karl-hong/magazineLock/doc/bullet_lock_v1.pdf

# 弹仓锁

## 4PIN

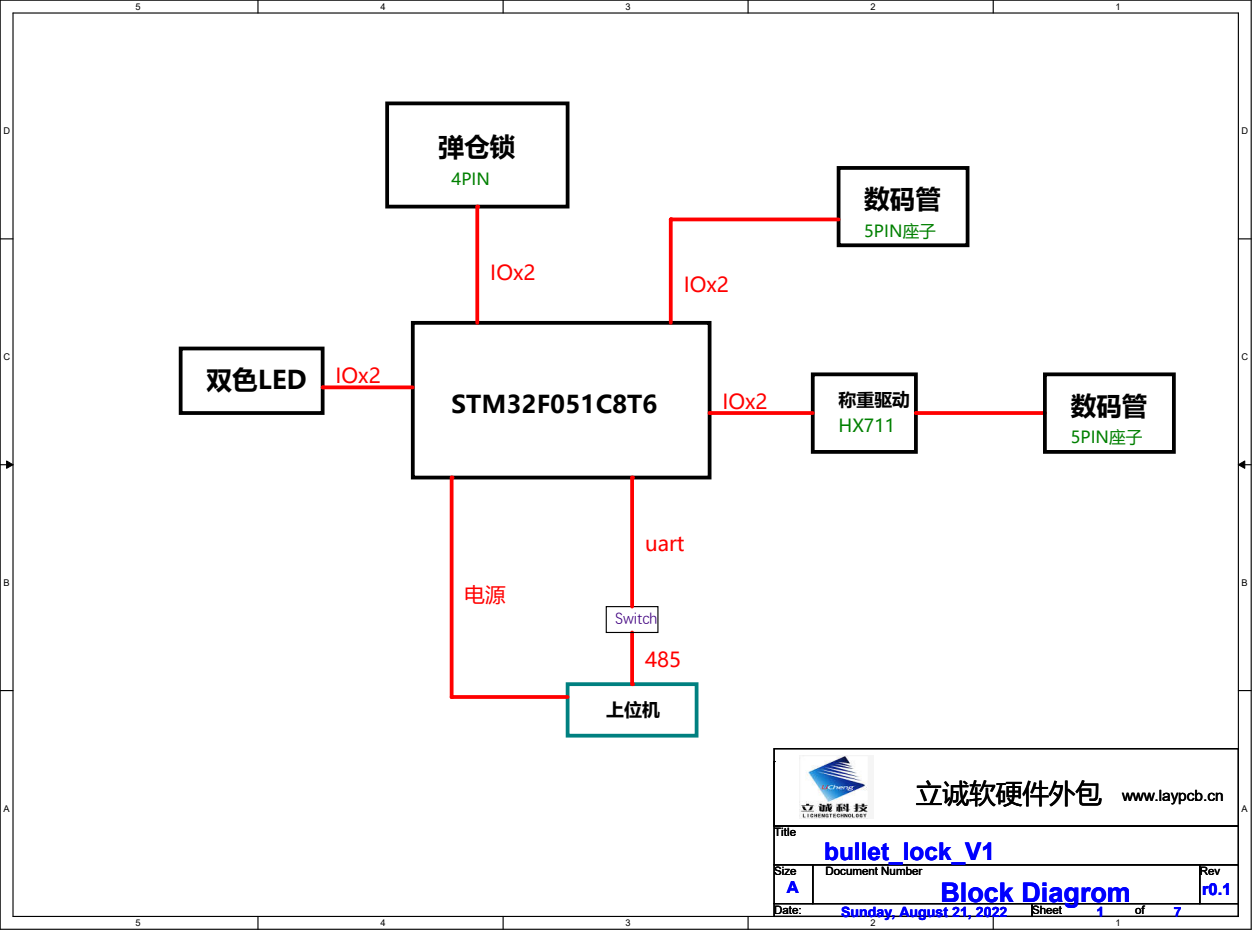
[picture p4: page 1]
STM32F051C8T6; 称重驱动; IOx2; 双色LED IOx2; 上位机; uart; Switch; 数码管; 5PIN座子; Title; Size; Document Number; Rev; Date:; Sheet; Block Diagrom; bullet_lock_V1; Sunday, August 21, 2022

立诚软硬件外包 www.laypcb.cn

# Revision

V1 | 2022.8.18 | 创建第一个版本

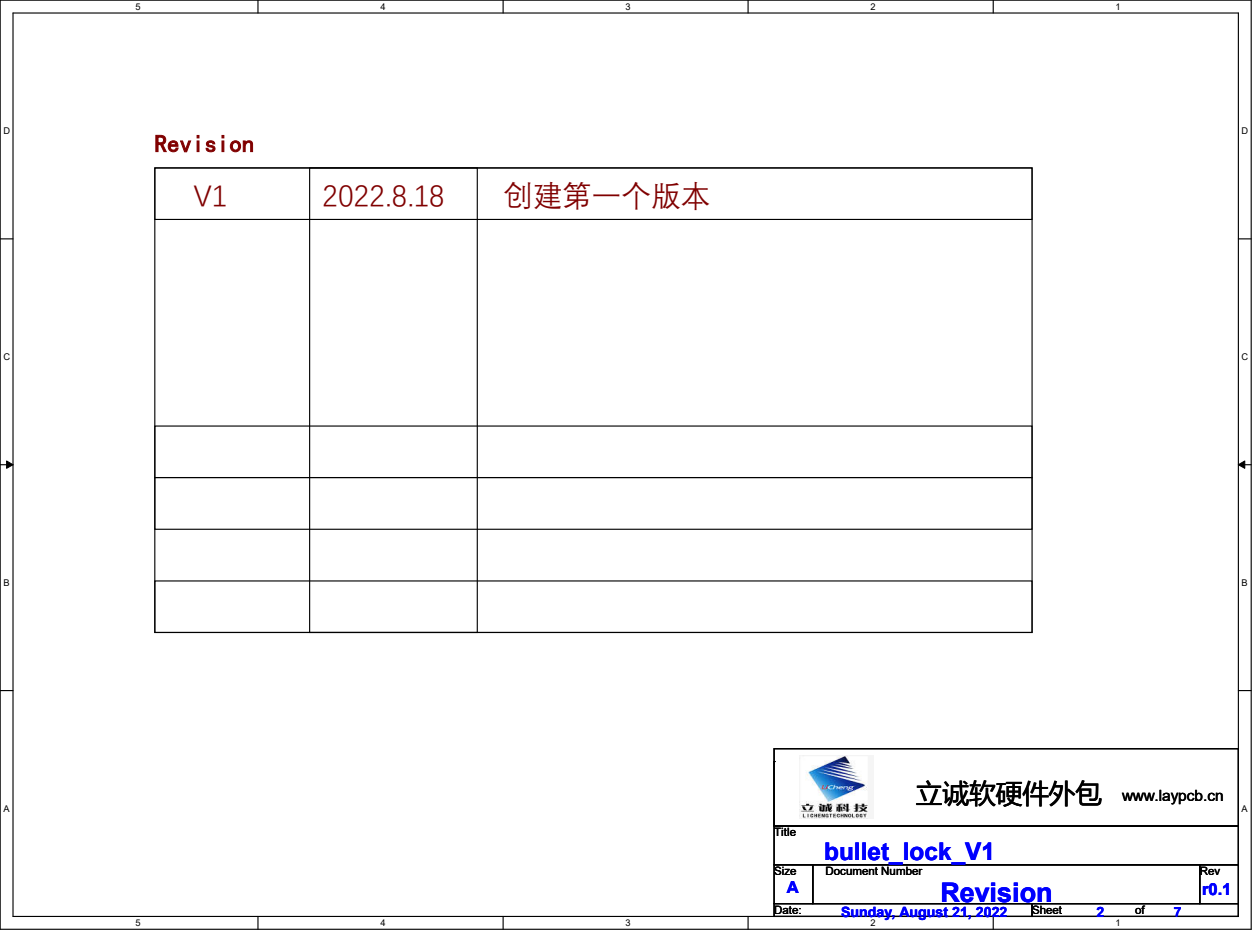
[picture p5: page 2]
Title; Revision; bullet_lock_V1; Sunday, August 21, 2022

立诚软硬件外包 www.laypcb.cn

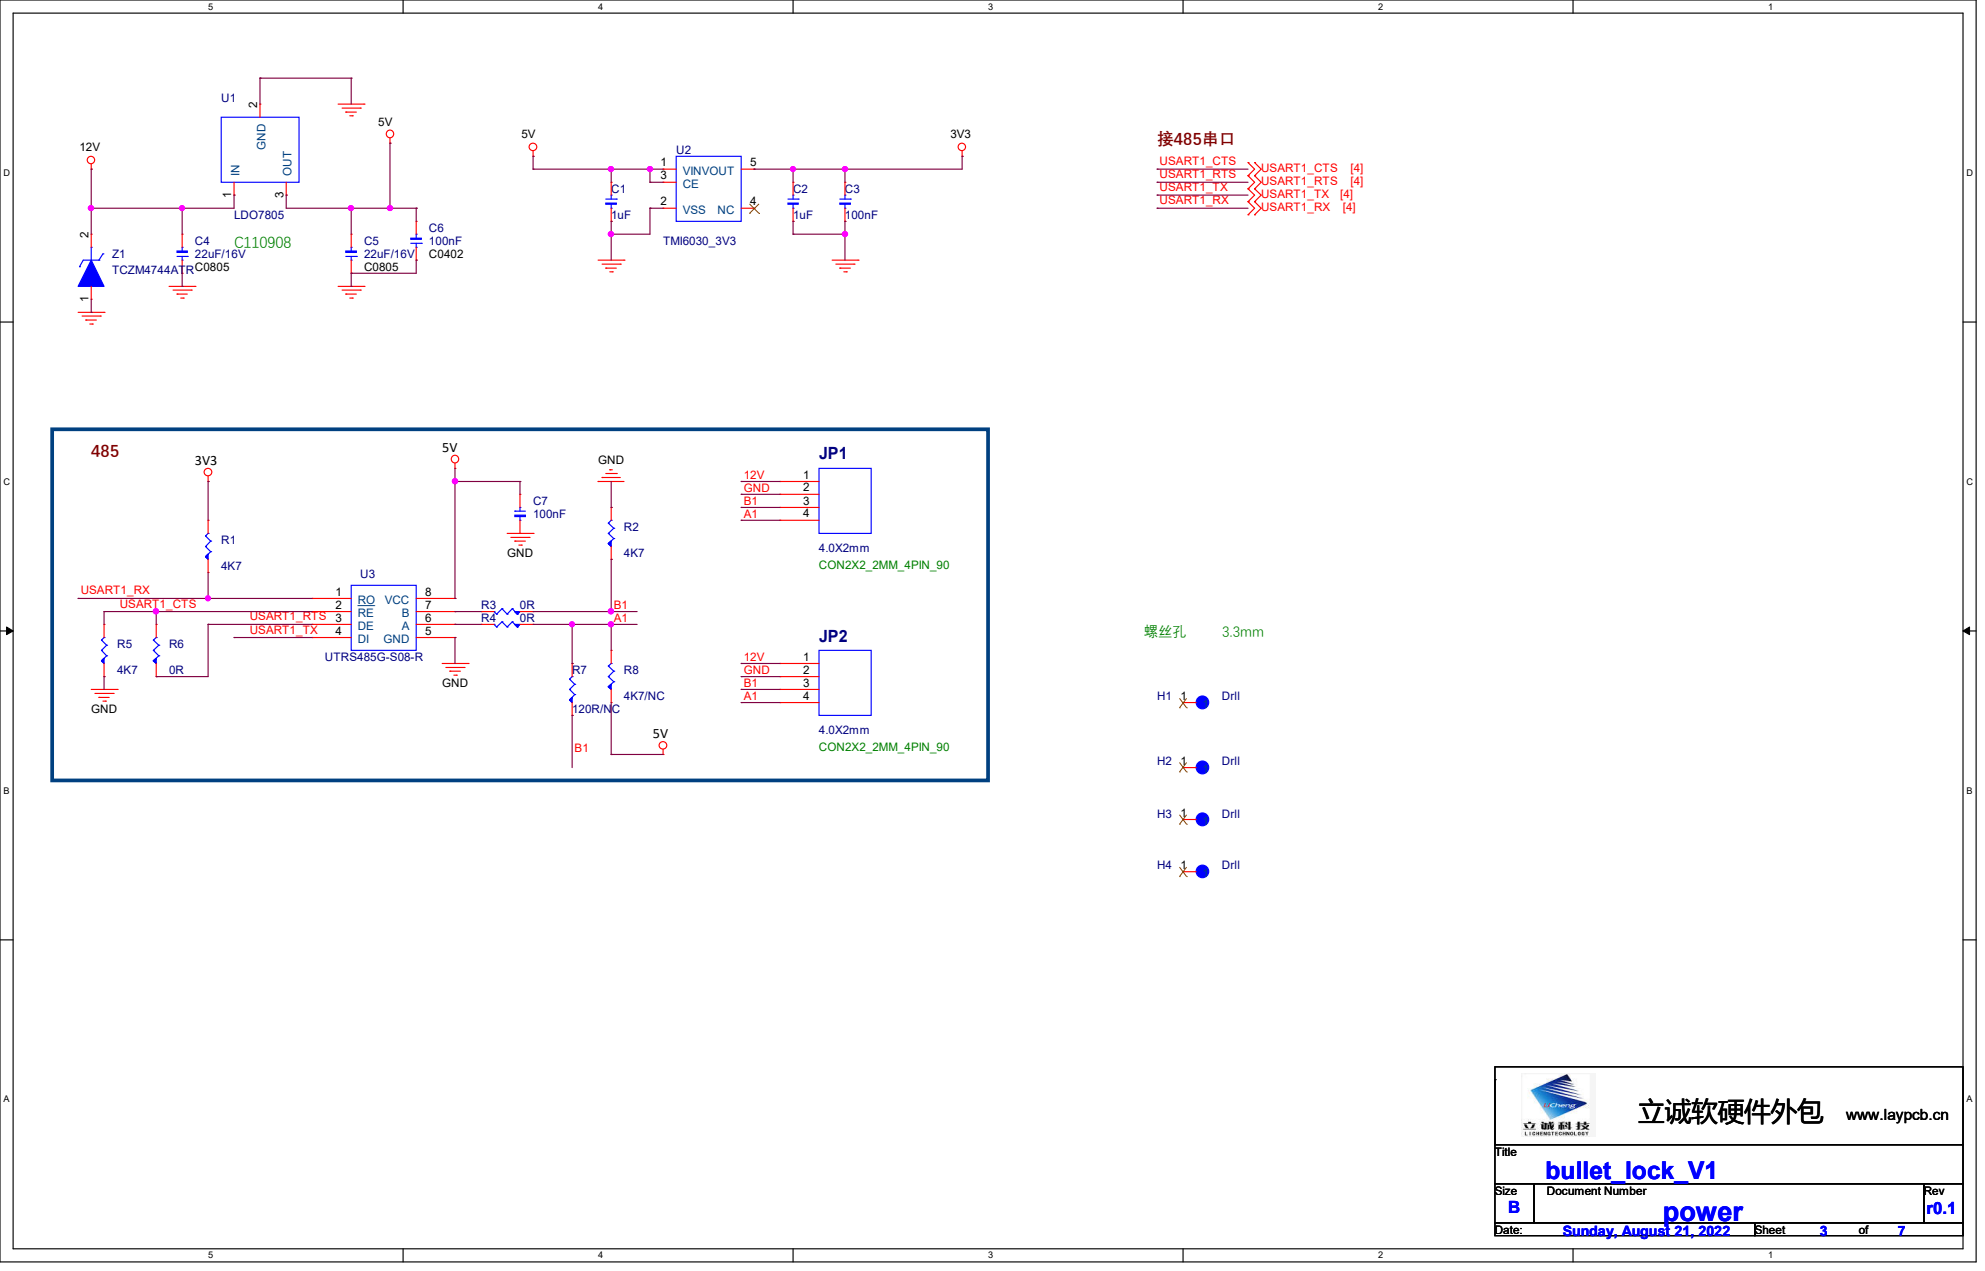
[picture p6: page 3]

立诚软硬件外包 www.laypcb.cn

## 接485串口

## 开锁和锁状态检测

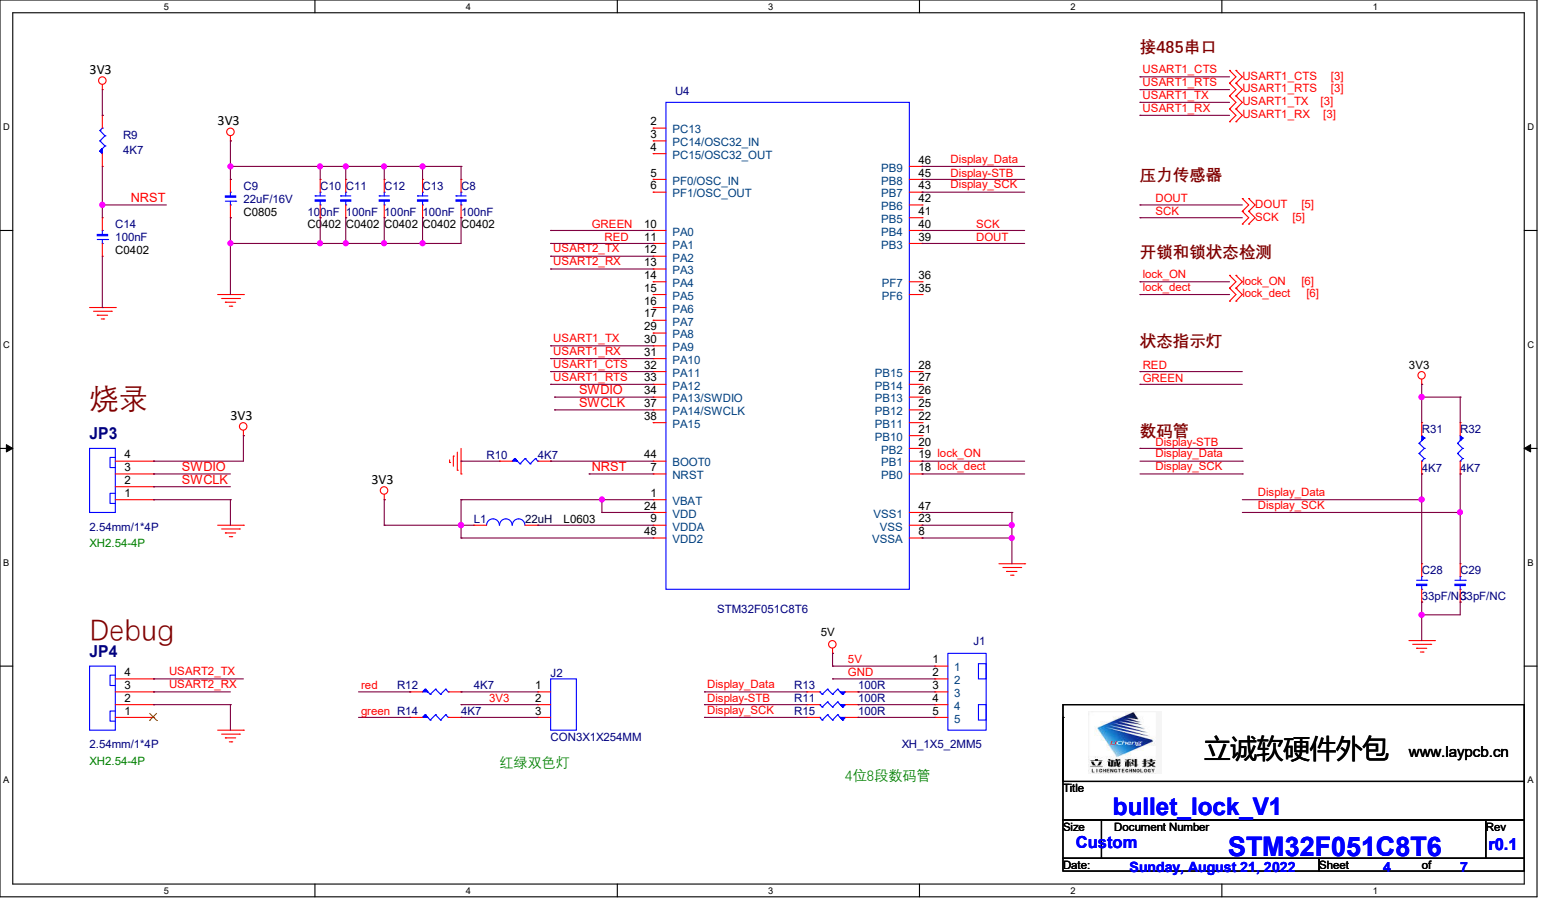
[picture p7: page 4]

立诚软硬件外包 www.laypcb.cn

## 压力传感器

5V

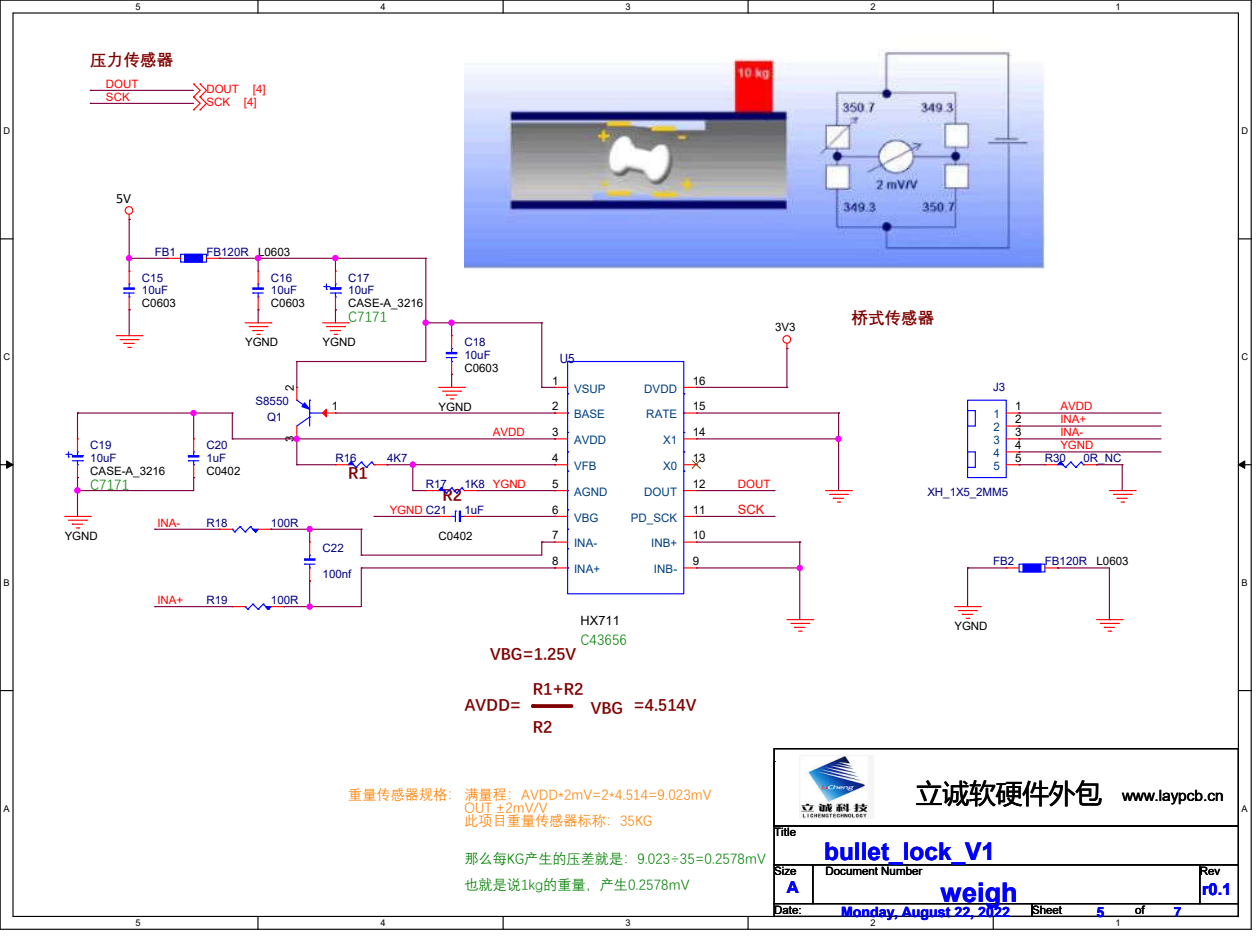
[picture p8: page 5]

立诚软硬件外包 www.laypcb.cn

## 上锁断开，开锁导通

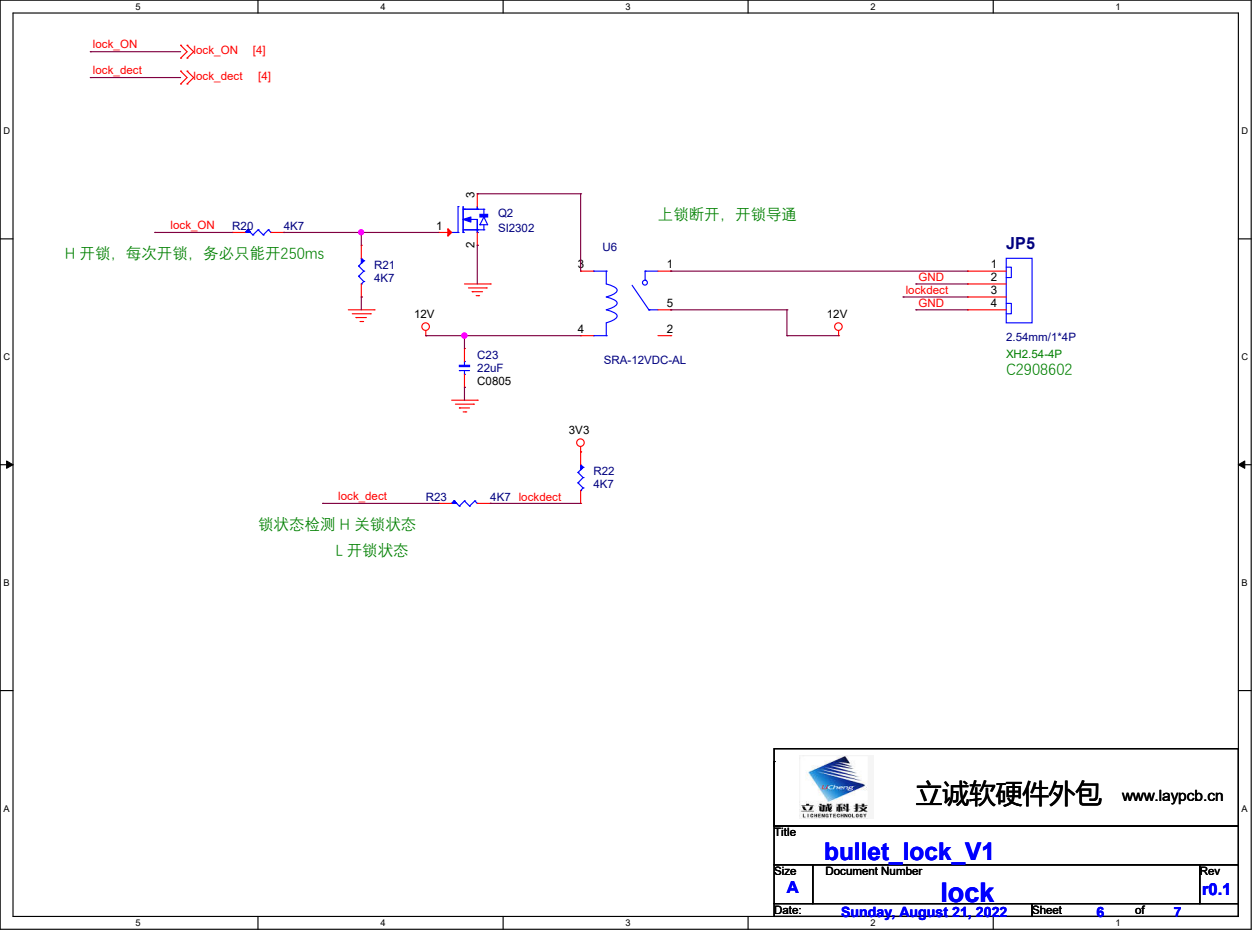
[picture p9: page 6]

立诚软硬件外包 www.laypcb.cn

## 4位8段数码管

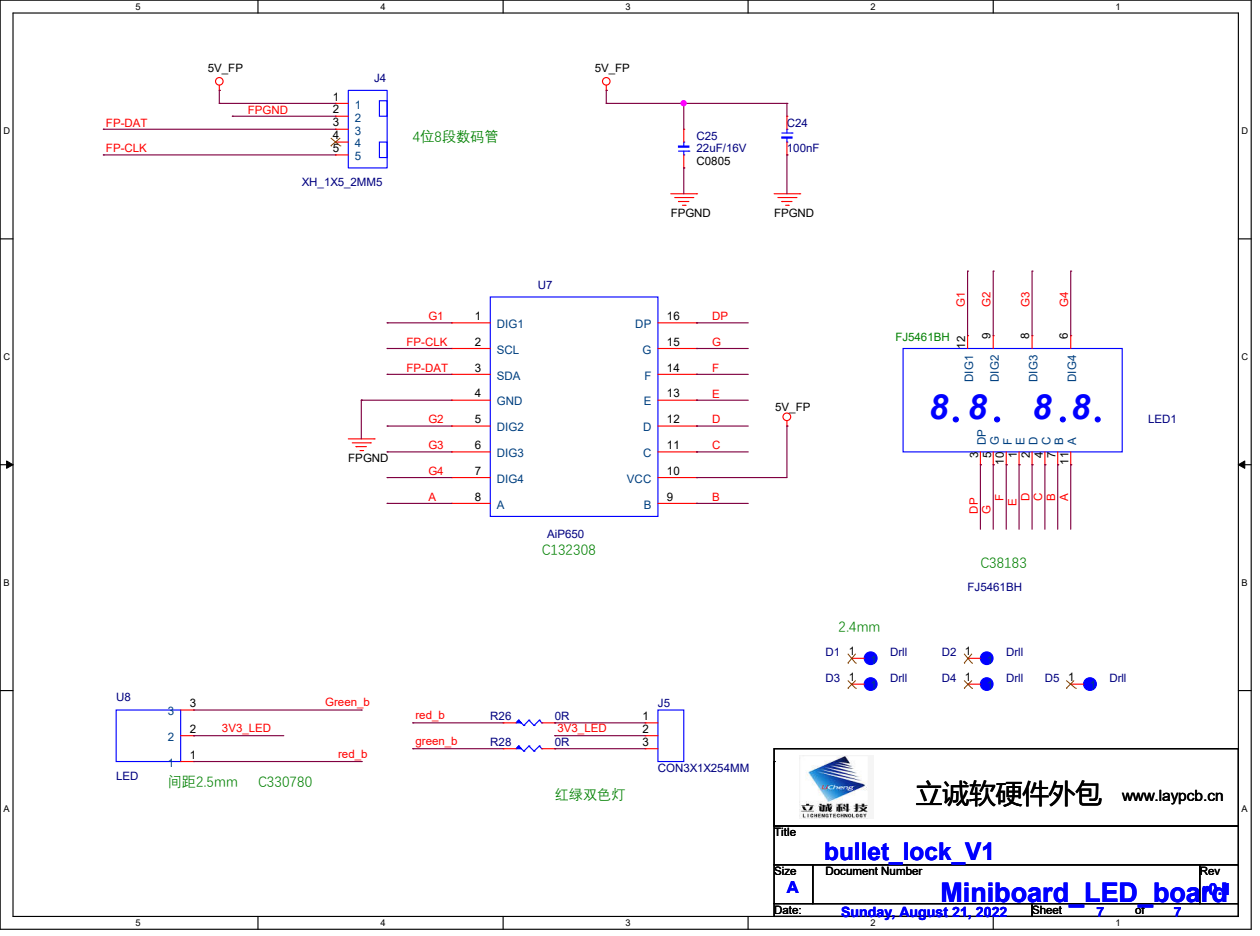
[picture p10: page 7]

立诚软硬件外包 www.laypcb.cn
