karl-hong/magazineLock/magazineLock/Core/Src/main.c

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
/* Includes ------------------------------------------------------------------*/
#include "main.h"
#include "iwdg.h"
#include "tim.h"
#include "usart.h"
#include "gpio.h"

/* USER CODE BEGIN Includes */
#include <stdio.h>
#include "user_protocol.h"
#include "common.h"
#include "user_data.h"
#include "AiP650.h"
#include "led.h"
#include "HX711.h"
#include "lock.h"
/* USER CODE END Includes */


/* USER CODE BEGIN PV */
lock_ctrl_t lock;
uint16_t logInterval = 0;
uint64_t u64ActWeight;
/* USER CODE END PV */

void SystemClock_Config(void);
/**
  * @brief  The application entry point.
  * @retval int
  */
int main(void)
{
  /* MCU Configuration--------------------------------------------------------*/

  /* Reset of all peripherals, Initializes the Flash interface and the Systick. */
  HAL_Init();

  /* USER CODE BEGIN Init */
	user_database_init();
  /* USER CODE END Init */

  /* Configure the system clock */
  SystemClock_Config();

  /* Initialize all configured peripherals */
  MX_GPIO_Init();
  MX_TIM14_Init();
  MX_USART1_UART_Init();
  MX_USART2_UART_Init();
  MX_IWDG_Init();
  /* USER CODE BEGIN 2 */
	AIP650Init();
	printSetting();
  lock_state_detect();
  /* USER CODE END 2 */

  /* Infinite loop */
  /* USER CODE BEGIN WHILE */
  while (1)
  {
    /* USER CODE END WHILE */

    /* USER CODE BEGIN 3 */
    MX_IWDG_Refresh();
		AIP650Task();
		Led_Task();
		HX711_task();
    Lock_Task();
    user_protocol_handle();
    user_reply_handle();
		user_huart_error_check();
		if(logInterval == 0){
			logInterval = 30;
      static uint32_t init_weight = 0;
      static uint32_t actual_weight = 0;
      if(init_weight == 0 && lock.magazineWeight){
        init_weight = lock.magazineWeight;
      }
      if(lock.magazineWeight >= init_weight){
        actual_weight = lock.magazineWeight - init_weight;
        actual_weight = actual_weight * 30 / 4456;//000;//206000;//2147483;
      }
			//printf("hx711 weight: %d kg\r\n", actual_weight);
			printf("hx711 weight: %d g\r\n", actual_weight);
		}
  }
  /* USER CODE END 3 */
}

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
