karl-hong/magazineLock/magazineLock/magazineLock.ioc

Mcu.UserName=STM32F051C8Tx
PA0.GPIO_Label=Gled
PA0.Signal=GPIO_Output
PA1.GPIO_Label=Rled
PA1.Signal=GPIO_Output
PA10.Signal=USART1_RX
PA12.Signal=USART1_DE
PA2.Signal=USART2_TX
PA3.Signal=USART2_RX
PA9.Signal=USART1_TX
PB0.GPIO_Label=Lock_Dect
PB0.Signal=GPXTI0
PB1.GPIO_Label=Lock_On
PB1.Signal=GPIO_Output
PB3.GPIO_Label=HX711_Dat
PB3.Signal=GPIO_Input
PB4.GPIO_Label=HX711_Sck
PB4.Signal=GPIO_Output
PB7.GPIO_Label=Dsip_Sck
PB7.Signal=GPIO_Output
PB8.GPIO_Label=Disp_STB
PB8.Signal=GPIO_Output
PB9.GPIO_Label=Disp_Dat
PB9.Signal=GPIO_Output
