karl-hong/magazineLock/magazineLock/Core/Inc/main.h

#define Gled_Pin GPIO_PIN_0
#define Gled_GPIO_Port GPIOA
#define Rled_Pin GPIO_PIN_1
#define Rled_GPIO_Port GPIOA
#define Lock_Dect_Pin GPIO_PIN_0
#define Lock_Dect_GPIO_Port GPIOB
#define Lock_Dect_EXTI_IRQn EXTI0_1_IRQn
#define Lock_On_Pin GPIO_PIN_1
#define Lock_On_GPIO_Port GPIOB
#define HX711_Dat_Pin GPIO_PIN_3
#define HX711_Dat_GPIO_Port GPIOB
#define HX711_Sck_Pin GPIO_PIN_4
#define HX711_Sck_GPIO_Port GPIOB
#define Dsip_Sck_Pin GPIO_PIN_7
#define Dsip_Sck_GPIO_Port GPIOB
#define Disp_STB_Pin GPIO_PIN_8
#define Disp_STB_GPIO_Port GPIOB
#define Disp_Dat_Pin GPIO_PIN_9
#define Disp_Dat_GPIO_Port GPIOB
