karl-hong/magazineLock/magazineLock/App/Src/user_data.c

#include <stdio.h>
#include "user_data.h"
#include "common.h"
#include "user_protocol.h"
#include "stm32f0xx_hal.h"
#include "stm32f0xx_hal_flash_ex.h"  

void onCmdQueryDeviceStatus(uint8_t *data, uint16_t length)
{
    uint32_t uid0;
    uint32_t uid1;
    uint32_t uid2;
    uint16_t pos = 0;

    if(length < 12){
        printf("[%s]length error!\r\n", __FUNCTION__);
        return;
    }

    uid0 = (data[pos++] << 24);
    uid0 += (data[pos++] << 16);
    uid0 += (data[pos++] << 8);
    uid0 += data[pos++];

    uid1 = (data[pos++] << 24);
    uid1 += (data[pos++] << 16);
    uid1 += (data[pos++] << 8);
    uid1 += data[pos++];

    uid2 = (data[pos++] << 24);
    uid2 += (data[pos++] << 16);
    uid2 += (data[pos++] << 8);
    uid2 += data[pos++];

    if(lock.uid0 != uid0 || lock.uid1 != uid1 || lock.uid2 != uid2){
        printf("[%s]UID is not matched!\r\n", __FUNCTION__);
        return;
    }

    /* send dev status here */
    lock.cmdControl.reportStatus.sendCmdEnable = CMD_ENABLE;
    lock.cmdControl.reportStatus.sendCmdDelay = 0;
}

void onCmdSetDeviceStatus(uint8_t *data, uint16_t length, uint8_t ack)
{
    uint32_t uid0;
    uint32_t uid1;
    uint32_t uid2;
    uint16_t pos = 0;
    uint8_t lockSetState;
    uint16_t cmdLength;

    if(NULL == data){
        printf("[%s]data is null!\r\n", __FUNCTION__);
        return;
    }

    if(ack) cmdLength = 13;
    else    cmdLength = 1;

    if(cmdLength > length){
        printf("[%s]length error!\r\n", __FUNCTION__);
        return;
    }

    lockSetState = data[pos++];

    if(!ack){
        goto out;
    }

    uid0 = (data[pos++] << 24);
    uid0 += (data[pos++] << 16);
    uid0 += (data[pos++] << 8);
    uid0 += data[pos++];

    uid1 = (data[pos++] << 24);
    uid1 += (data[pos++] << 16);
    uid1 += (data[pos++] << 8);
    uid1 += data[pos++];

    uid2 = (data[pos++] << 24);
    uid2 += (data[pos++] << 16);
    uid2 += (data[pos++] << 8);
    uid2 += data[pos++];

    if(lock.uid0 != uid0 || lock.uid1 != uid1 || lock.uid2 != uid2){
        printf("[%s]UID is not matched!\r\n", __FUNCTION__);
        return;
    }
out:
    /* set dev state here */
    if(lockSetState == 0 && lock.lockDetectState){
        lock.lockTaskState = LOCK_TASK_STATE_UNLOCK;//unlock
        /* set led state here */
        // lock.ledTask.state = LED_TASK_STATE_FLASH;
    }
    /* send ack msg here */
    if(ack){
        lock.cmdControl.operateResult.sendCmdEnable = CMD_ENABLE;
        lock.cmdControl.operateResult.sendCmdDelay = lock.lockReplyDelay * DELAY_BASE;
    }
}

void onCmdModifyDeviceSetting(uint8_t *data, uint16_t length, uint8_t ack)
{
    uint32_t uid0;
    uint32_t uid1;
    uint32_t uid2;
    uint16_t pos = 0;
    // uint32_t lockDelay;
    // uint16_t lockReplyDelay;
    uint8_t  isReport;
    uint8_t  addr;
    uint16_t cmdLength;

    if(NULL == data){
        printf("[%s]data is null!\r\n", __FUNCTION__);
        return;
    }

    if(ack) cmdLength = 13;//18;
    else    cmdLength = 1;

    if(cmdLength > length){
        printf("[%s]length error!\r\n", __FUNCTION__);
        return;
    }

    if(ack) addr = data[pos++];

    // lockDelay = data[pos++] << 16;
    // lockDelay += data[pos++] << 8;
    // lockDelay += data[pos++];
    
    // lockReplyDelay = data[pos++] << 8;
    // lockReplyDelay += data[pos++];
    
    isReport = data[pos++];

    if(!ack){
        goto out;
    }

    uid0 = (data[pos++] << 24);
    uid0 += (data[pos++] << 16);
    uid0 += (data[pos++] << 8);
    uid0 += data[pos++];

    uid1 = (data[pos++] << 24);
    uid1 += (data[pos++] << 16);
    uid1 += (data[pos++] << 8);
    uid1 += data[pos++];

    uid2 = (data[pos++] << 24);
    uid2 += (data[pos++] << 16);
    uid2 += (data[pos++] << 8);
    uid2 += data[pos++];

    printf("uid: 0x%x%x%x\r\n", uid0, uid1, uid2);

    if(lock.uid0 != uid0 || lock.uid1 != uid1 || lock.uid2 != uid2){
        printf("[%s]UID is not matched!\r\n", __FUNCTION__);
        return;
    }
out:
    /* set dev state here */
    if(ack) lock.address = addr;
    // lock.lockDelay = lockDelay;
    // lock.lockReplyDelay = lockReplyDelay;
    lock.isReport = isReport;
    user_database_save();
    /* send ack msg here */
    if(ack){
        lock.cmdControl.basicSetting.sendCmdEnable = CMD_ENABLE;
        lock.cmdControl.basicSetting.sendCmdDelay = 0;
    }
}

void onCmdSetLedFlash(uint8_t *data, uint16_t length, uint8_t ack)
{
    uint32_t uid0;
    uint32_t uid1;
    uint32_t uid2;
    uint16_t pos = 0;
    uint8_t  isFlash;
    uint16_t cmdLength;

    if(NULL == data){
        printf("[%s]data is null!\r\n", __FUNCTION__);
        return;
    }

    if(ack) cmdLength = 13;
    else    cmdLength = 1;

    if(cmdLength > length){
        printf("[%s]length error!\r\n", __FUNCTION__);
        return;
    }   

    isFlash = data[pos++];

    if(!ack){
        goto out;
    }

    uid0 = (data[pos++] << 24);
    uid0 += (data[pos++] << 16);
    uid0 += (data[pos++] << 8);
    uid0 += data[pos++];

    uid1 = (data[pos++] << 24);
    uid1 += (data[pos++] << 16);
    uid1 += (data[pos++] << 8);
    uid1 += data[pos++];

    uid2 = (data[pos++] << 24);
    uid2 += (data[pos++] << 16);
    uid2 += (data[pos++] << 8);
    uid2 += data[pos++];

    if(lock.uid0 != uid0 || lock.uid1 != uid1 || lock.uid2 != uid2){
        printf("[%s]UID is not matched!\r\n", __FUNCTION__);
        return;
    }
out:
    /* set led flash here */
    lock.ledFlashStatus = isFlash;
    // user_database_save();

    lock.ledTask.state = isFlash;
    /* send ack msg here */
    if(ack){
        lock.cmdControl.ledFlashSetting.sendCmdEnable = CMD_ENABLE;
        lock.cmdControl.ledFlashSetting.sendCmdDelay = 0;
    }
}

void onCmdClrDevAlarmSetting(uint8_t *data, uint16_t length, uint8_t ack)
{
    uint32_t uid0;
    uint32_t uid1;
    uint32_t uid2;
    uint16_t pos = 0;
    uint16_t cmdLength; 

    if(!ack){
        goto out;
    } 

    cmdLength = 12;
    if(cmdLength > length){
       printf("[%s]length error!\r\n", __FUNCTION__);
        return;
    }

    uid0 = (data[pos++] << 24);
    uid0 += (data[pos++] << 16);
    uid0 += (data[pos++] << 8);
    uid0 += data[pos++];

    uid1 = (data[pos++] << 24);
    uid1 += (data[pos++] << 16);
    uid1 += (data[pos++] << 8);
    uid1 += data[pos++];

    uid2 = (data[pos++] << 24);
    uid2 += (data[pos++] << 16);
    uid2 += (data[pos++] << 8);
    uid2 += data[pos++];

    if(lock.uid0 != uid0 || lock.uid1 != uid1 || lock.uid2 != uid2){
        printf("[%s]UID is not matched!\r\n", __FUNCTION__);
        return;
    }
out:
    /* send ack msg here */
    if(ack){
        /* clear device alarm setting here */
        lock.alarmStatus = 0;
        lock.cmdControl.alarmSetting.sendCmdEnable = CMD_ENABLE;
        lock.cmdControl.alarmSetting.sendCmdDelay = 0;
    }else{
        lock.alarmStatus = 0;
    }

    user_database_save();
}

void onCmdGetWeight(uint8_t *data, uint16_t length)
{
    uint32_t uid0;
    uint32_t uid1;
    uint32_t uid2;
    uint16_t pos = 0;

    if(length < 12){
        printf("[%s]length error!\r\n", __FUNCTION__);
        return;
    }

    uid0 = (data[pos++] << 24);
    uid0 += (data[pos++] << 16);
    uid0 += (data[pos++] << 8);
    uid0 += data[pos++];

    uid1 = (data[pos++] << 24);
    uid1 += (data[pos++] << 16);
    uid1 += (data[pos++] << 8);
    uid1 += data[pos++];

    uid2 = (data[pos++] << 24);
    uid2 += (data[pos++] << 16);
    uid2 += (data[pos++] << 8);
    uid2 += data[pos++];

    if(lock.uid0 != uid0 || lock.uid1 != uid1 || lock.uid2 != uid2){
        printf("[%s]UID is not matched!\r\n", __FUNCTION__);
        return;
    }

    /* send weight msg here */
    lock.cmdControl.reportWeight.sendCmdEnable = CMD_ENABLE;
    lock.cmdControl.reportWeight.sendCmdDelay = 0;
}

void onCmdSetDispContent(uint8_t *data, uint16_t length)
{
    uint32_t uid0;
    uint32_t uid1;
    uint32_t uid2;
    uint16_t pos = 0;
    uint16_t magazinNum = 0;

    if(length < 14){
        printf("[%s]length error!\r\n", __FUNCTION__);
        return;
    }

    magazinNum = (data[pos++] << 8);
    magazinNum += data[pos++];

    uid0 = (data[pos++] << 24);
    uid0 += (data[pos++] << 16);
    uid0 += (data[pos++] << 8);
    uid0 += data[pos++];

    uid1 = (data[pos++] << 24);
    uid1 += (data[pos++] << 16);
    uid1 += (data[pos++] << 8);
    uid1 += data[pos++];

    uid2 = (data[pos++] << 24);
    uid2 += (data[pos++] << 16);
    uid2 += (data[pos++] << 8);
    uid2 += data[pos++];

    if(lock.uid0 != uid0 || lock.uid1 != uid1 || lock.uid2 != uid2){
        printf("[%s]UID is not matched!\r\n", __FUNCTION__);
        return;
    }

    lock.magazineNum = magazinNum;

    /* send msg here */
	lock.cmdControl.reportMagazineNum.sendCmdEnable = CMD_ENABLE;
	lock.cmdControl.reportMagazineNum.sendCmdDelay = 0;
}

void onCmdClrDispContent(uint8_t *data, uint16_t length, uint8_t ack)
{
    uint32_t uid0;
    uint32_t uid1;
    uint32_t uid2;
    uint16_t pos = 0;
    uint16_t cmdLength; 

    if(!ack){
        goto out;
    } 

    cmdLength = 12;
    if(cmdLength > length){
       printf("[%s]length error!\r\n", __FUNCTION__);
        return;
    }

    uid0 = (data[pos++] << 24);
    uid0 += (data[pos++] << 16);
    uid0 += (data[pos++] << 8);
    uid0 += data[pos++];

    uid1 = (data[pos++] << 24);
    uid1 += (data[pos++] << 16);
    uid1 += (data[pos++] << 8);
    uid1 += data[pos++];

    uid2 = (data[pos++] << 24);
    uid2 += (data[pos++] << 16);
    uid2 += (data[pos++] << 8);
    uid2 += data[pos++];

    if(lock.uid0 != uid0 || lock.uid1 != uid1 || lock.uid2 != uid2){
        printf("[%s]UID is not matched!\r\n", __FUNCTION__);
        return;
    }
out:
    lock.magazineNum = 0;
    /* send ack msg here */
    if(ack){
        lock.cmdControl.clrDisp.sendCmdEnable = CMD_ENABLE;
        lock.cmdControl.clrDisp.sendCmdDelay = 0;
    }

    // user_database_save();
}

void onCmdSetCalibrationParam(uint8_t *data, uint16_t length)
{
    uint32_t uid0;
    uint32_t uid1;
    uint32_t uid2;
    uint8_t valueK[6];
    uint8_t valueB[6];
    uint16_t pos = 0;

    if(length < 24){
        printf("[%s]length error!\r\n", __FUNCTION__);
        return;
    }

    valueK[0] = data[pos++];
    valueK[1] = data[pos++];
    valueK[2] = data[pos++];
    valueK[3] = data[pos++];
    valueK[4] = data[pos++];
    valueK[5] = data[pos++];

    valueB[0] = data[pos++];
    valueB[1] = data[pos++];
    valueB[2] = data[pos++];
    valueB[3] = data[pos++];
    valueB[4] = data[pos++];
    valueB[5] = data[pos++];

    uid0 = (data[pos++] << 24);
    uid0 += (data[pos++] << 16);
    uid0 += (data[pos++] << 8);
    uid0 += data[pos++];

    uid1 = (data[pos++] << 24);
    uid1 += (data[pos++] << 16);
    uid1 += (data[pos++] << 8);
    uid1 += data[pos++];

    uid2 = (data[pos++] << 24);
    uid2 += (data[pos++] << 16);
    uid2 += (data[pos++] << 8);
    uid2 += data[pos++];

    if(lock.uid0 != uid0 || lock.uid1 != uid1 || lock.uid2 != uid2){
        printf("[%s]UID is not matched!\r\n", __FUNCTION__);
        return;
    }
    /* set calibration param */
    for(uint8_t i=0;i<6;i++){
        lock.valueK[i] = valueK[i];
        lock.valueB[i] = valueB[i];
    }

    /* send calibration param msg here */
    lock.cmdControl.setCalibrationParamAck.sendCmdEnable = CMD_ENABLE;
    lock.cmdControl.setCalibrationParamAck.sendCmdDelay = 0;

    /* save calibration */
    user_database_save();
}

void onCmdGetCalibrationParam(uint8_t *data, uint16_t length)
{
    uint32_t uid0;
    uint32_t uid1;
    uint32_t uid2;
    uint16_t pos = 0;

    if(length < 12){
        printf("[%s]length error!\r\n", __FUNCTION__);
        return;
    }

    uid0 = (data[pos++] << 24);
    uid0 += (data[pos++] << 16);
    uid0 += (data[pos++] << 8);
    uid0 += data[pos++];

    uid1 = (data[pos++] << 24);
    uid1 += (data[pos++] << 16);
    uid1 += (data[pos++] << 8);
    uid1 += data[pos++];

    uid2 = (data[pos++] << 24);
    uid2 += (data[pos++] << 16);
    uid2 += (data[pos++] << 8);
    uid2 += data[pos++];

    if(lock.uid0 != uid0 || lock.uid1 != uid1 || lock.uid2 != uid2){
        printf("[%s]UID is not matched!\r\n", __FUNCTION__);
        return;
    }

    /* send calibration param msg here */
    lock.cmdControl.getCalibrationParamAck.sendCmdEnable = CMD_ENABLE;
    lock.cmdControl.getCalibrationParamAck.sendCmdDelay = 0;
}

void onCmdSetDeviceStatusByAddr(uint8_t *data, uint16_t length)
{
    uint16_t pos = 0;
    uint8_t lockSetState;
    uint16_t cmdLength = 2;
    uint16_t addr;

    if(NULL == data){
        printf("[%s]data is null!\r\n", __FUNCTION__);
        return;
    }

    if(cmdLength > length){
        printf("[%s]length error!\r\n", __FUNCTION__);
        return;
    }

    lockSetState = data[pos++];
    addr = data[pos++];

    if(lock.address != addr){
        printf("[%s]addr is not matched!\r\n", __FUNCTION__);
        return;
    }
out:
    /* set dev state here */
    if(lockSetState == 0 && lock.lockDetectState){
        lock.lockTaskState = LOCK_TASK_STATE_UNLOCK;//unlock
        /* set led state here */
        // lock.ledTask.state = LED_TASK_STATE_FLASH;
    }
}

void onCmdSetLedFlashByAddr(uint8_t *data, uint16_t length)
{
    uint16_t pos = 0;
    uint8_t  isFlash;
    uint16_t cmdLength = 2;
    uint16_t addr;

    if(NULL == data){
        printf("[%s]data is null!\r\n", __FUNCTION__);
        return;
    }

    if(cmdLength > length){
        printf("[%s]length error!\r\n", __FUNCTION__);
        return;
    }   

    isFlash = data[pos++];
    addr = data[pos++];

    if(lock.address != addr){
        printf("[%s]addr is not matched!\r\n", __FUNCTION__);
        return;
    }
out:
    /* set led flash here */
    lock.ledFlashStatus = isFlash;
    // user_database_save();

    lock.ledTask.state = isFlash;
}

void onCmdClrDevAlarmSettingByAddr(uint8_t *data, uint16_t length)
{
    uint16_t pos = 0;
    uint16_t cmdLength = 1; 
    uint16_t addr;

    if(NULL == data){
        printf("[%s]data is null!\r\n", __FUNCTION__);
        return;
    }

    if(cmdLength > length){
       printf("[%s]length error!\r\n", __FUNCTION__);
        return;
    }

    addr = data[pos++];

    if(lock.address != addr){
        printf("[%s]addr is not matched!\r\n", __FUNCTION__);
        return;
    }
out:
    /* send ack msg here */
 
    lock.alarmStatus = 0;

    user_database_save();
}

void onCmdClrDispContentByAddr(uint8_t *data, uint16_t length)
{
    uint16_t pos = 0;
    uint16_t cmdLength = 1; 
    uint16_t addr;

    if(NULL == data){
        printf("[%s]data is null!\r\n", __FUNCTION__);
        return;
    }

    if(cmdLength > length){
       printf("[%s]length error!\r\n", __FUNCTION__);
        return;
    }

     addr = data[pos++];

    if(lock.address != addr){
        printf("[%s]addr is not matched!\r\n", __FUNCTION__);
        return;
    }
out:
    lock.magazineNum = 0;
    /* send ack msg here */
    // user_database_save();
}

void onCmdSetDispContentByAddr(uint8_t *data, uint16_t length)
{
    uint16_t pos = 0;
    uint16_t magazinNum = 0;
    uint16_t addr;

    if(length != 3){
        printf("[%s]length error!\r\n", __FUNCTION__);
        return;
    }

    magazinNum = (data[pos++] << 8);
    magazinNum += data[pos++];

    addr = data[pos++];

    if(lock.address != addr){
        printf("[%s]addr is not matched!\r\n", __FUNCTION__);
        return;
    }

    lock.magazineNum = magazinNum;
}

void onCmdSetMultiDevsDispContent(uint8_t *data, uint16_t length)
{
    uint16_t pos = 0;
    uint16_t magazinNum = 0;

    if(length != 2){
        printf("[%s]length error!\r\n", __FUNCTION__);
        return;
    }

    magazinNum = (data[pos++] << 8);
    magazinNum += data[pos++];

    lock.magazineNum = magazinNum;
}

void onCmdModifyBaudRate(uint8_t *data, uint16_t length, uint8_t ack)
{
    uint32_t uid0;
    uint32_t uid1;
    uint32_t uid2;
    uint16_t pos = 0;
    uint8_t baudRateIndex = 0;

    baudRateIndex = data[pos++];

    if(!ack){
        goto out;
    } 

    uid0 = (data[pos++] << 24);
    uid0 += (data[pos++] << 16);
    uid0 += (data[pos++] << 8);
    uid0 += data[pos++];

    uid1 = (data[pos++] << 24);
    uid1 += (data[pos++] << 16);
    uid1 += (data[pos++] << 8);
    uid1 += data[pos++];

    uid2 = (data[pos++] << 24);
    uid2 += (data[pos++] << 16);
    uid2 += (data[pos++] << 8);
    uid2 += data[pos++]; 

    if(lock.uid0 != uid0 || lock.uid1 != uid1 || lock.uid2 != uid2){
        printf("[%s]UID is not matched!\r\n", __FUNCTION__);
        return;
    }  
out: 
    lock.baudRateIndex = baudRateIndex;

    user_database_save();

    if(ack){
        /* send ack msg */
        lock.cmdControl.singleModifyBaudRate.sendCmdEnable = CMD_ENABLE;
        lock.cmdControl.singleModifyBaudRate.sendCmdDelay = 0;
    }else{
        while(1);//wait for watchdog reset
    }
}

void onReportDeviceStatus(void)
{
    uint8_t buffer[23];
    uint8_t pos = 0;
    buffer[pos++] = lock.address;
    buffer[pos++] = lock.lockState;
   // buffer[pos++] = lock.gunState;
    // buffer[pos++] = (lock.lockDelay >> 16) & 0xff;
    // buffer[pos++] = (lock.lockDelay >> 8) & 0xff;
    // buffer[pos++] = lock.lockDelay & 0xff;
    // buffer[pos++] = (lock.lockReplyDelay >> 8) & 0xff;
    // buffer[pos++] = lock.lockReplyDelay & 0xff;
    buffer[pos++] = lock.ledFlashStatus;
    buffer[pos++] = lock.alarmStatus;
    buffer[pos++] = lock.isReport;
    buffer[pos++] = (lock.uid0 >> 24)& 0xff;
    buffer[pos++] = (lock.uid0 >> 16) & 0xff;
    buffer[pos++] = (lock.uid0 >> 8) & 0xff;
    buffer[pos++] = lock.uid0 & 0xff;
    buffer[pos++] = (lock.uid1 >> 24)& 0xff;
    buffer[pos++] = (lock.uid1 >> 16) & 0xff;
    buffer[pos++] = (lock.uid1 >> 8) & 0xff;
    buffer[pos++] = lock.uid1 & 0xff;
    buffer[pos++] = (lock.uid2 >> 24)& 0xff;
    buffer[pos++] = (lock.uid2 >> 16) & 0xff;
    buffer[pos++] = (lock.uid2 >> 8) & 0xff;
    buffer[pos++] = lock.uid2 & 0xff;
    
    user_protocol_send_data(CMD_ACK, OPTION_QUERY_SINGLE_LOCK_STATUS, buffer, pos);       
}

void onReportDeviceOptResult(void)
{
    uint8_t buffer[14];
    uint8_t pos = 0;
    buffer[pos++] = lock.address;
    buffer[pos++] = lock.lockState;
    buffer[pos++] = (lock.uid0 >> 24)& 0xff;
    buffer[pos++] = (lock.uid0 >> 16) & 0xff;
    buffer[pos++] = (lock.uid0 >> 8) & 0xff;
    buffer[pos++] = lock.uid0 & 0xff;
    buffer[pos++] = (lock.uid1 >> 24)& 0xff;
    buffer[pos++] = (lock.uid1 >> 16) & 0xff;
    buffer[pos++] = (lock.uid1 >> 8) & 0xff;
    buffer[pos++] = lock.uid1 & 0xff;
    buffer[pos++] = (lock.uid2 >> 24)& 0xff;
    buffer[pos++] = (lock.uid2 >> 16) & 0xff;
    buffer[pos++] = (lock.uid2 >> 8) & 0xff;
    buffer[pos++] = lock.uid2 & 0xff;

    user_protocol_send_data(CMD_ACK, OPTION_LOCK_SINGLE_DEVICE, buffer, pos);    
}

void onReportSetDeviceResult(void)
{
    uint8_t buffer[23];
    uint8_t pos = 0;
    buffer[pos++] = lock.address;
    // buffer[pos++] = (lock.lockDelay >> 8) & 0xff;
    // buffer[pos++] = (lock.lockDelay >> 16) & 0xff;
    // buffer[pos++] = lock.lockReplyDelay & 0xff;
    // buffer[pos++] = (lock.lockReplyDelay >> 8) & 0xff;
    buffer[pos++] = lock.isReport;
    buffer[pos++] = (lock.uid0 >> 24)& 0xff;
    buffer[pos++] = (lock.uid0 >> 16) & 0xff;
    buffer[pos++] = (lock.uid0 >> 8) & 0xff;
    buffer[pos++] = lock.uid0 & 0xff;
    buffer[pos++] = (lock.uid1 >> 24)& 0xff;
    buffer[pos++] = (lock.uid1 >> 16) & 0xff;
    buffer[pos++] = (lock.uid1 >> 8) & 0xff;
    buffer[pos++] = lock.uid1 & 0xff;
    buffer[pos++] = (lock.uid2 >> 24)& 0xff;
    buffer[pos++] = (lock.uid2 >> 16) & 0xff;
    buffer[pos++] = (lock.uid2 >> 8) & 0xff;
    buffer[pos++] = lock.uid2 & 0xff;

    user_protocol_send_data(CMD_ACK, OPTION_SET_SINGLE_DEVICE, buffer, pos);     
}

void onReportSetLedFlashStatus(void)
{
    uint8_t buffer[23];
    uint8_t pos = 0;
    buffer[pos++] = lock.address;
    buffer[pos++] = lock.ledFlashStatus;
    buffer[pos++] = (lock.uid0 >> 24)& 0xff;
    buffer[pos++] = (lock.uid0 >> 16) & 0xff;
    buffer[pos++] = (lock.uid0 >> 8) & 0xff;
    buffer[pos++] = lock.uid0 & 0xff;
    buffer[pos++] = (lock.uid1 >> 24)& 0xff;
    buffer[pos++] = (lock.uid1 >> 16) & 0xff;
    buffer[pos++] = (lock.uid1 >> 8) & 0xff;
    buffer[pos++] = lock.uid1 & 0xff;
    buffer[pos++] = (lock.uid2 >> 24)& 0xff;
    buffer[pos++] = (lock.uid2 >> 16) & 0xff;
    buffer[pos++] = (lock.uid2 >> 8) & 0xff;
    buffer[pos++] = lock.uid2 & 0xff;

    user_protocol_send_data(CMD_ACK, OPTION_SET_SINGLE_DEVICE_LED, buffer, pos);     
}

void onReportClearDevAlarmSetting(void)
{
    uint8_t buffer[23];
    uint8_t pos = 0;
    buffer[pos++] = lock.address;
    buffer[pos++] = lock.alarmStatus;
    buffer[pos++] = (lock.uid0 >> 24)& 0xff;
    buffer[pos++] = (lock.uid0 >> 16) & 0xff;
    buffer[pos++] = (lock.uid0 >> 8) & 0xff;
    buffer[pos++] = lock.uid0 & 0xff;
    buffer[pos++] = (lock.uid1 >> 24)& 0xff;
    buffer[pos++] = (lock.uid1 >> 16) & 0xff;
    buffer[pos++] = (lock.uid1 >> 8) & 0xff;
    buffer[pos++] = lock.uid1 & 0xff;
    buffer[pos++] = (lock.uid2 >> 24)& 0xff;
    buffer[pos++] = (lock.uid2 >> 16) & 0xff;
    buffer[pos++] = (lock.uid2 >> 8) & 0xff;
    buffer[pos++] = lock.uid2 & 0xff;

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
    buffer[pos++] = (lock.uid2 >> 24)& 0xff;
    buffer[pos++] = (lock.uid2 >> 16) & 0xff;
    buffer[pos++] = (lock.uid2 >> 8) & 0xff;
    buffer[pos++] = lock.uid2 & 0xff;

    user_protocol_send_data(CMD_ACK, OPTION_CLR_SIGNLE_LOCK_DISP_CONTENT, buffer, pos);    
}

void onReportSetCalibrationParam(void)
{
    uint8_t buffer[30];
    uint8_t pos = 0;
    buffer[pos++] = lock.valueK[0];
    buffer[pos++] = lock.valueK[1];
    buffer[pos++] = lock.valueK[2];
    buffer[pos++] = lock.valueK[3];
    buffer[pos++] = lock.valueK[4];
    buffer[pos++] = lock.valueK[5];
    buffer[pos++] = lock.valueB[0];
    buffer[pos++] = lock.valueB[1];
    buffer[pos++] = lock.valueB[2];
    buffer[pos++] = lock.valueB[3];
    buffer[pos++] = lock.valueB[4];
    buffer[pos++] = lock.valueB[5];
    buffer[pos++] = (lock.uid0 >> 24)& 0xff;
    buffer[pos++] = (lock.uid0 >> 16) & 0xff;
    buffer[pos++] = (lock.uid0 >> 8) & 0xff;
    buffer[pos++] = lock.uid0 & 0xff;
    buffer[pos++] = (lock.uid1 >> 24)& 0xff;
    buffer[pos++] = (lock.uid1 >> 16) & 0xff;
    buffer[pos++] = (lock.uid1 >> 8) & 0xff;
    buffer[pos++] = lock.uid1 & 0xff;
    buffer[pos++] = (lock.uid2 >> 24)& 0xff;
    buffer[pos++] = (lock.uid2 >> 16) & 0xff;
    buffer[pos++] = (lock.uid2 >> 8) & 0xff;
    buffer[pos++] = lock.uid2 & 0xff;

    user_protocol_send_data(CMD_ACK, OPTION_SET_CALIBRATION_PARAM, buffer, pos); 
}

void onReportGetCalibrationParam(void)
{
    uint8_t buffer[30];
    uint8_t pos = 0;
    buffer[pos++] = lock.valueK[0];
    buffer[pos++] = lock.valueK[1];
    buffer[pos++] = lock.valueK[2];
    buffer[pos++] = lock.valueK[3];
    buffer[pos++] = lock.valueK[4];
    buffer[pos++] = lock.valueK[5];
    buffer[pos++] = lock.valueB[0];
    buffer[pos++] = lock.valueB[1];
    buffer[pos++] = lock.valueB[2];
    buffer[pos++] = lock.valueB[3];
    buffer[pos++] = lock.valueB[4];
    buffer[pos++] = lock.valueB[5];
    buffer[pos++] = (lock.uid0 >> 24)& 0xff;
    buffer[pos++] = (lock.uid0 >> 16) & 0xff;
    buffer[pos++] = (lock.uid0 >> 8) & 0xff;
    buffer[pos++] = lock.uid0 & 0xff;
    buffer[pos++] = (lock.uid1 >> 24)& 0xff;
    buffer[pos++] = (lock.uid1 >> 16) & 0xff;
    buffer[pos++] = (lock.uid1 >> 8) & 0xff;
    buffer[pos++] = lock.uid1 & 0xff;
    buffer[pos++] = (lock.uid2 >> 24)& 0xff;
    buffer[pos++] = (lock.uid2 >> 16) & 0xff;
    buffer[pos++] = (lock.uid2 >> 8) & 0xff;
    buffer[pos++] = lock.uid2 & 0xff;

    user_protocol_send_data(CMD_ACK, OPTION_GET_CALIBRATION_PARAM, buffer, pos); 
}

void onReportSingleModifyBaudRate(void)
{
    uint8_t buffer[23];
    uint8_t pos = 0;
    /* addr */
    buffer[pos++] = lock.address;
    /* lock baudRateIndex */
    buffer[pos++] = lock.baudRateIndex;
    /* UID */
    buffer[pos++] = (lock.uid0 >> 24)& 0xff;
    buffer[pos++] = (lock.uid0 >> 16) & 0xff;
    buffer[pos++] = (lock.uid0 >> 8) & 0xff;
    buffer[pos++] = lock.uid0 & 0xff;
    buffer[pos++] = (lock.uid1 >> 24)& 0xff;
    buffer[pos++] = (lock.uid1 >> 16) & 0xff;
    buffer[pos++] = (lock.uid1 >> 8) & 0xff;
    buffer[pos++] = lock.uid1 & 0xff;
    buffer[pos++] = (lock.uid2 >> 24)& 0xff;
    buffer[pos++] = (lock.uid2 >> 16) & 0xff;
    buffer[pos++] = (lock.uid2 >> 8) & 0xff;
    buffer[pos++] = lock.uid2 & 0xff;

    user_protocol_send_data(CMD_ACK, OPT_CODE_SINGLE_MODIFY_BAUDRATE, buffer, pos); 

    while(1);//wait for watchdog reset 
}

uint16_t user_read_flash(uint32_t address)
{
    return *(__IO uint16_t*)address;
}

void user_database_init(void)
{
    uint16_t i;
    uint16_t lenOfDataBase = sizeof(database_t) / sizeof(uint16_t);
    database_t readDataBase;
    uint16_t *pData = (uint16_t *)&readDataBase;

    memset((uint8_t *)&lock, 0, sizeof(lock));

    printf("\r\n******************** App Start ********************\r\n");

    lock.uid0 = HAL_GetUIDw0();
    lock.uid1 = HAL_GetUIDw1();
    lock.uid2 = HAL_GetUIDw2();

    for(i=0;i<lenOfDataBase;i++){
        pData[i] = user_read_flash(DATABASE_START_ADDR + 2U*i);
    }

    if(DATABASE_MAGIC != readDataBase.magic){
        printf("Init Database!!!\r\n");
        lock.lockDelay = DEFAULT_LOCK_DELAY;
        lock.lockReplyDelay = DEFAULT_LOCK_REPLY_DELAY;
        lock.isReport = DEFAULT_LOCK_REPORT;
        lock.ledFlashStatus = DEFAULT_LOCK_LED_FLASH;
        for(i=0;i<6;i++){
            lock.valueK[i] = DEFAULT_CALI_VALUE;
            lock.valueB[i] = DEFAULT_CALI_VALUE;
        }
        lock.baudRateIndex = DEFAULT_BAUD_RATE_INDEX;

        user_database_save();
    }else{
        printf("Read database from flash!!!\r\n");
        lock.address = (uint8_t )readDataBase.address;
        lock.lockDelay = readDataBase.lockDelayLow;
        lock.lockDelay += (readDataBase.lockDelayHigh << 16);
        lock.lockReplyDelay = readDataBase.lockReplyDelay;
        lock.isReport = (uint8_t)readDataBase.isReport;
        lock.ledFlashStatus = (uint8_t)readDataBase.ledFlash;
        for(i=0;i<6;i++){
            lock.valueK[i] = readDataBase.valueK[i];
            lock.valueB[i] = readDataBase.valueB[i];
        }
        lock.baudRateIndex = (readDataBase.baudRateIndex == 0xffff) ? DEFAULT_BAUD_RATE_INDEX : readDataBase.baudRateIndex;
    }
}

void user_database_save(void)
{
    uint16_t i;
    uint16_t lenOfDataBase = sizeof(database_t) / sizeof(uint16_t);
    database_t writeDataBase;
    uint16_t *pData = (uint16_t *)&writeDataBase;
    HAL_StatusTypeDef status;
    FLASH_EraseInitTypeDef flashEraseInitType;
    uint32_t PageError;

    writeDataBase.magic = DATABASE_MAGIC;
    writeDataBase.address = lock.address;
    writeDataBase.isReport = lock.isReport;
    writeDataBase.ledFlash = lock.ledFlashStatus;
    writeDataBase.lockDelayLow = lock.lockDelay & 0xffff;
    writeDataBase.lockDelayHigh = (lock.lockDelay >> 16) & 0xffff;
    writeDataBase.lockReplyDelay = lock.lockReplyDelay;
    for(i=0;i<6;i++){
        writeDataBase.valueK[i] = lock.valueK[i];
        writeDataBase.valueB[i] = lock.valueB[i];
    }
    writeDataBase.baudRateIndex = lock.baudRateIndex;

    HAL_FLASH_Unlock();

    flashEraseInitType.TypeErase = FLASH_TYPEERASE_PAGES;
    flashEraseInitType.PageAddress = DATABASE_START_ADDR;
    flashEraseInitType.NbPages = 1;
    status = HAL_FLASHEx_Erase(&flashEraseInitType, &PageError);
    
    if(HAL_OK != status){
        HAL_FLASH_Lock();
        printf("Flash erase error: %d\r\n", status);
        return;
    }

    for(i=0;i<lenOfDataBase;i++){
       if(HAL_OK != HAL_FLASH_Program(FLASH_TYPEPROGRAM_HALFWORD, DATABASE_START_ADDR + 2U*i, pData[i])){
            printf("[%s]write data[%d] fail!\r\n", __FUNCTION__, i);
       } 
    }

    HAL_FLASH_Lock();
}

void user_reply_handle(void)
{
    if(lock.cmdControl.reportStatus.sendCmdEnable && !lock.cmdControl.reportStatus.sendCmdDelay){
        lock.cmdControl.reportStatus.sendCmdEnable = CMD_DISABLE;
        onReportDeviceStatus();
    }

    if(lock.cmdControl.operateResult.sendCmdEnable && !lock.cmdControl.operateResult.sendCmdDelay){
        lock.cmdControl.operateResult.sendCmdEnable = CMD_DISABLE;
        onReportDeviceOptResult();
    }

    if(lock.cmdControl.basicSetting.sendCmdEnable && !lock.cmdControl.basicSetting.sendCmdDelay){
        lock.cmdControl.basicSetting.sendCmdEnable = CMD_DISABLE;
        onReportSetDeviceResult();
    }

    if(lock.cmdControl.ledFlashSetting.sendCmdEnable && !lock.cmdControl.ledFlashSetting.sendCmdDelay){
        lock.cmdControl.ledFlashSetting.sendCmdEnable = CMD_DISABLE;
        onReportSetLedFlashStatus();
    }

    if(lock.cmdControl.alarmSetting.sendCmdEnable && !lock.cmdControl.alarmSetting.sendCmdDelay){
        lock.cmdControl.alarmSetting.sendCmdEnable = CMD_DISABLE;
        onReportClearDevAlarmSetting();
    }

    if(lock.cmdControl.reportOperateStatus.sendCmdEnable && !lock.cmdControl.reportOperateStatus.sendCmdDelay){
        lock.cmdControl.reportOperateStatus.sendCmdEnable = CMD_DISABLE;
        onReportDevAlarm(lock.lockState);
    }
		
    if(lock.cmdControl.reportWeight.sendCmdEnable && !lock.cmdControl.reportWeight.sendCmdDelay){
        lock.cmdControl.reportWeight.sendCmdEnable = CMD_DISABLE;
        onReportWeight();   
    }
    
    if(lock.cmdControl.reportMagazineNum.sendCmdEnable && !lock.cmdControl.reportMagazineNum.sendCmdDelay){
        lock.cmdControl.reportMagazineNum.sendCmdEnable = CMD_DISABLE;
        onReportMagazineNum();  
    }
    
    if(lock.cmdControl.clrDisp.sendCmdEnable && !lock.cmdControl.clrDisp.sendCmdDelay){
        lock.cmdControl.clrDisp.sendCmdEnable = CMD_DISABLE;
        onReportClrDisp();
    }

    if(lock.cmdControl.unlockFault.sendCmdEnable && !lock.cmdControl.unlockFault.sendCmdDelay){
        lock.cmdControl.unlockFault.sendCmdEnable = CMD_DISABLE;
        onReportUnlockFault();
    }

    if(lock.cmdControl.setCalibrationParamAck.sendCmdEnable && !lock.cmdControl.setCalibrationParamAck.sendCmdDelay){
        lock.cmdControl.setCalibrationParamAck.sendCmdEnable = CMD_DISABLE;
        onReportSetCalibrationParam();
    }

    if(lock.cmdControl.getCalibrationParamAck.sendCmdEnable && !lock.cmdControl.getCalibrationParamAck.sendCmdDelay){
        lock.cmdControl.getCalibrationParamAck.sendCmdEnable = CMD_DISABLE;
        onReportGetCalibrationParam();
    }

    if(lock.cmdControl.singleModifyBaudRate.sendCmdEnable && !lock.cmdControl.singleModifyBaudRate.sendCmdDelay){
        lock.cmdControl.singleModifyBaudRate.sendCmdEnable = CMD_DISABLE;
        onReportSingleModifyBaudRate();
    }
}

void printSetting(void)
{
		printf("Chip uuid: 0x%x%x%x\r\n", lock.uid0, lock.uid1, lock.uid2);
    printf("address: 0x%X\r\n", lock.address);
    printf("isReport: 0x%X\r\n", lock.isReport);
    printf("ledFlash: 0x%X\r\n", lock.ledFlashStatus);
    printf("lockDelay: 0x%X\r\n", lock.lockDelay);
    printf("lockReplyDelay: 0x%X\r\n", lock.lockReplyDelay);
		printf("baudRateIndex: 0x%02X\r\n", lock.baudRateIndex);
}
