karl-hong/magazineLock/magazineLock/Core/Src/tim.c

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
/* Includes ------------------------------------------------------------------*/
#include "tim.h"

/* USER CODE BEGIN 0 */
#include "common.h"
/* USER CODE END 0 */

TIM_HandleTypeDef htim14;

/* TIM14 init function */
void MX_TIM14_Init(void)
{

  htim14.Instance = TIM14;
  htim14.Init.Prescaler = 1000;
  htim14.Init.CounterMode = TIM_COUNTERMODE_UP;
  htim14.Init.Period = 1201;
  htim14.Init.ClockDivision = TIM_CLOCKDIVISION_DIV1;
  htim14.Init.AutoReloadPreload = TIM_AUTORELOAD_PRELOAD_ENABLE;
  if (HAL_TIM_Base_Init(&htim14) != HAL_OK)
  {
    Error_Handler();
  }
  /* USER CODE BEGIN TIM14_Init 2 */
  HAL_TIM_Base_Start_IT(&htim14);
  /* USER CODE END TIM14_Init 2 */

}

void HAL_TIM_Base_MspInit(TIM_HandleTypeDef* tim_baseHandle)
{

  if(tim_baseHandle->Instance==TIM14)
  {
    /* TIM14 clock enable */
    __HAL_RCC_TIM14_CLK_ENABLE();

    /* TIM14 interrupt Init */
    HAL_NVIC_SetPriority(TIM14_IRQn, 2, 0);
    HAL_NVIC_EnableIRQ(TIM14_IRQn);
  }
}

void HAL_TIM_Base_MspDeInit(TIM_HandleTypeDef* tim_baseHandle)
{

  if(tim_baseHandle->Instance==TIM14)
  {
    /* Peripheral clock disable */
    __HAL_RCC_TIM14_CLK_DISABLE();

    /* TIM14 interrupt Deinit */
    HAL_NVIC_DisableIRQ(TIM14_IRQn);
  }
}

/* USER CODE BEGIN 1 */
extern uint16_t logInterval;
extern void app_set_lock_state(uint8_t state);
void HAL_TIM_PeriodElapsedCallback(TIM_HandleTypeDef *htim)
{
    if(htim->Instance == TIM14){
			/* 100ms */
      if(lock.cmdControl.reportStatus.sendCmdDelay > 0) lock.cmdControl.reportStatus.sendCmdDelay --;

      if(lock.cmdControl.operateResult.sendCmdDelay > 0) lock.cmdControl.operateResult.sendCmdDelay --;

      if(lock.cmdControl.basicSetting.sendCmdDelay > 0) lock.cmdControl.basicSetting.sendCmdDelay --;

      if(lock.cmdControl.ledFlashSetting.sendCmdDelay > 0) lock.cmdControl.ledFlashSetting.sendCmdDelay --;

      if(lock.cmdControl.alarmSetting.sendCmdDelay > 0) lock.cmdControl.alarmSetting.sendCmdDelay --;

      if(lock.cmdControl.reportOperateStatus.sendCmdDelay > 0) lock.cmdControl.reportOperateStatus.sendCmdDelay --;

      if( lock.cmdControl.unlockFault.sendCmdDelay > 0)  lock.cmdControl.unlockFault.sendCmdDelay --;

      if( lock.cmdControl.setCalibrationParamAck.sendCmdDelay > 0)  lock.cmdControl.setCalibrationParamAck.sendCmdDelay --;

      if( lock.cmdControl.getCalibrationParamAck.sendCmdDelay > 0)  lock.cmdControl.getCalibrationParamAck.sendCmdDelay --;

      if(lock.ledTask.state == LED_TASK_STATE_FLASH){
          lock.ledTask.flashCnt ++;
          if(FLASH_FREQ <= lock.ledTask.flashCnt){
              lock.ledTask.flashCnt = 0;
              lock.ledTask.flashOn = !lock.ledTask.flashOn;
          }
      }else{
        lock.ledTask.flashOn = 0;
        lock.ledTask.flashCnt = 0;
      }

      /* unlock action only last 400ms */
      if(lock.lockTaskLatencyCnt > 0){
        lock.lockTaskLatencyCnt --;
        if(lock.lockTaskLatencyCnt == 0){
          app_set_lock_state(LOCK_STATE_LOCK);
          lock.lockTaskState = LOCK_TASK_STATE_IDLE;
          //lock.ledTask.state = LED_TASK_STATE_IDLE;
        }
      }

      /* check manual lock operate */
      if(lock.manulLockState != lock.lockState){
        // if(lock.manulLockState == LOCK_STATE_UNLOCK && lock.isReport){
        //   /* 关锁 */
        //   lock.cmdControl.reportOperateStatus.sendCmdEnable = CMD_ENABLE;
        //   lock.cmdControl.reportOperateStatus.sendCmdDelay = 5;
        // }
        if(lock.isReport){
          /* 手动开关锁上报 */
          lock.cmdControl.reportOperateStatus.sendCmdEnable = CMD_ENABLE;
          lock.cmdControl.reportOperateStatus.sendCmdDelay = 5;
        }
        lock.manulLockState = lock.lockState;
      }
			
      if(lock.lockState == LOCK_STATE_UNLOCK) lock.cmdControl.unlockFault.sendCmdEnable = CMD_DISABLE;
			
			if(logInterval > 0) logInterval --;

      if(lock.hx711Delay > 0) lock.hx711Delay --;
    }
}
/* USER CODE END 1 */
