karl-hong/magazineLock/magazineLock/Core/Src/gpio.c

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

/* Includes ------------------------------------------------------------------*/
#include "gpio.h"

/* USER CODE BEGIN 0 */
#include <stdio.h>
#include "common.h"
/* USER CODE END 0 */

/*----------------------------------------------------------------------------*/
/* Configure GPIO                                                             */
/*----------------------------------------------------------------------------*/
/** Configure pins
*/
void MX_GPIO_Init(void)
{

  GPIO_InitTypeDef GPIO_InitStruct = {0};

  /* GPIO Ports Clock Enable */
  __HAL_RCC_GPIOA_CLK_ENABLE();
  __HAL_RCC_GPIOB_CLK_ENABLE();

  /*Configure GPIO pin Output Level */
  HAL_GPIO_WritePin(GPIOA, Gled_Pin|Rled_Pin, GPIO_PIN_SET);

  /*Configure GPIO pin Output Level */
  HAL_GPIO_WritePin(GPIOB, Lock_On_Pin|HX711_Sck_Pin|Dsip_Sck_Pin|Disp_STB_Pin
                          |Disp_Dat_Pin, GPIO_PIN_RESET);

  /*Configure GPIO pins : PAPin PAPin */
  GPIO_InitStruct.Pin = Gled_Pin|Rled_Pin;
  GPIO_InitStruct.Mode = GPIO_MODE_OUTPUT_PP;
  GPIO_InitStruct.Pull = GPIO_NOPULL;
  GPIO_InitStruct.Speed = GPIO_SPEED_FREQ_HIGH;
  HAL_GPIO_Init(GPIOA, &GPIO_InitStruct);

  /*Configure GPIO pin : PtPin */
  GPIO_InitStruct.Pin = Lock_Dect_Pin;
  GPIO_InitStruct.Mode = GPIO_MODE_IT_RISING_FALLING;
  GPIO_InitStruct.Pull = GPIO_NOPULL;
  HAL_GPIO_Init(Lock_Dect_GPIO_Port, &GPIO_InitStruct);

  /*Configure GPIO pins : PBPin PBPin PBPin PBPin
                           PBPin */
  GPIO_InitStruct.Pin = Lock_On_Pin|HX711_Sck_Pin|Dsip_Sck_Pin|Disp_STB_Pin
                          |Disp_Dat_Pin;
  GPIO_InitStruct.Mode = GPIO_MODE_OUTPUT_PP;
  GPIO_InitStruct.Pull = GPIO_NOPULL;
  GPIO_InitStruct.Speed = GPIO_SPEED_FREQ_HIGH;
  HAL_GPIO_Init(GPIOB, &GPIO_InitStruct);

  /*Configure GPIO pin : PtPin */
  GPIO_InitStruct.Pin = HX711_Dat_Pin;
  GPIO_InitStruct.Mode = GPIO_MODE_INPUT;
  GPIO_InitStruct.Pull = GPIO_PULLUP;
  HAL_GPIO_Init(HX711_Dat_GPIO_Port, &GPIO_InitStruct);

  /**/
  HAL_I2CEx_EnableFastModePlus(SYSCFG_CFGR1_I2C_FMP_PB7);

  /**/
  HAL_I2CEx_EnableFastModePlus(SYSCFG_CFGR1_I2C_FMP_PB8);

  /**/
  HAL_I2CEx_EnableFastModePlus(SYSCFG_CFGR1_I2C_FMP_PB9);

  /* EXTI interrupt init*/
  HAL_NVIC_SetPriority(EXTI0_1_IRQn, 1, 0);
  HAL_NVIC_EnableIRQ(EXTI0_1_IRQn);

}

/* USER CODE BEGIN 2 */
void lock_state_detect(void)
{
  lock.lockDetectState = HAL_GPIO_ReadPin(Lock_Dect_GPIO_Port, Lock_Dect_Pin);
  if(lock.lockDetectState)  lock.lockState = LOCK_STATE_LOCK;
  else                      lock.lockState = LOCK_STATE_UNLOCK;
  lock.manulLockState = lock.lockState;
}
void HAL_GPIO_EXTI_Callback(uint16_t GPIO_Pin)
{
	if(Lock_Dect_Pin == GPIO_Pin){
		lock.lockDetectState = HAL_GPIO_ReadPin(Lock_Dect_GPIO_Port, Lock_Dect_Pin);
    lock.lockState = lock.lockDetectState;
	}
}

/* USER CODE END 2 */
