karl-hong/magazineLock/magazineLock/App/Src/HX711.c

/* Includes ------------------------------------------------------------------*/
#include "HX711.h"
#include "main.h"
#include "stdbool.h"
#include "stdint.h"
#include "stdio.h"
#include "common.h"

static uint8_t s_hx711_state = 0;
static uint16_t s_hx711_busy_cnt = 0;

void HX711_task(void)
{
     switch(s_hx711_state){
        case 1:{
            /* check convert complete */
            if(HAL_GPIO_ReadPin(HX711_Dat_GPIO_Port, HX711_Dat_Pin)){
                //printf("HX711 is busy!\r\n");
								s_hx711_busy_cnt ++;
								if(s_hx711_busy_cnt > 1000){
									s_hx711_state = 0;
                  lock.hx711Delay = 10;//1s
                  lock.magazineWeight = 0;
                  //printf("hx711 error!!!\r\n");
								}
                return;
            }

            /* read out hx711 data */
            uint32_t data = 0;
            uint32_t abs_data = 0;
            uint8_t i;
            for(i=0;i<24;i++){
                HAL_GPIO_WritePin(HX711_Sck_GPIO_Port, HX711_Sck_Pin, GPIO_PIN_SET);
                data = data<<1;
                HAL_GPIO_WritePin(HX711_Sck_GPIO_Port, HX711_Sck_Pin, GPIO_PIN_RESET);
                if(HAL_GPIO_ReadPin(HX711_Dat_GPIO_Port, HX711_Dat_Pin)){
                    data ++; 
                }
            }

            HAL_GPIO_WritePin(HX711_Sck_GPIO_Port, HX711_Sck_Pin, GPIO_PIN_SET);
            data = data^0x800000;
            HAL_GPIO_WritePin(HX711_Sck_GPIO_Port, HX711_Sck_Pin, GPIO_PIN_RESET);

            /* 获取绝对值 */
            // if(data >= 0x800000){
            //   /* 负数，获取原码 */
            //   abs_data = data & 0x7fffff;
            //   abs_data = ~(abs_data -1);
            //   abs_data &= 0x7fffff;
            // }else{
            //   /* 正数，原码与补码一样 */
            //   abs_data = data;
            // }
            /* 
            * 上面data = data ^ 0x800000;是将二进制补码换算为0x0~0xFFFFFF
            */
            // if(data >= 0x800000){
            //   abs_data = data - 0x800000;
            // }else{
            //   abs_data = 0x800000 -data;
            // }
            /* get hx711 data here */
            lock.magazineWeight = data;
						//lock.magazineWeight = abs_data * 1000 / HX711_FULL_RANGE * 1000 * HX711_AVDD / 2 / HX711_GAIN;
            //lock.magazineNum = lock.magazineWeight;
            //printf("org: 0x%x, abs_data: 0x%x\r\n", data, abs_data);
						//printf("data: 0x%x\r\n", data);
            /* goto next state */
            s_hx711_state = 0;
						lock.hx711Delay = 5;//1s
            break;
        }
        
        case 0:
        default:{
            if(lock.hx711Delay > 0) break;
            HAL_GPIO_WritePin(HX711_Sck_GPIO_Port, HX711_Sck_Pin, GPIO_PIN_RESET);
            s_hx711_state = 1;
						s_hx711_busy_cnt = 0;
            break;
        }
     }
}
