karl-hong/magazineLock/(commit log)

2022-09-26 增加基本功能
2022-09-27 数码管已OK
2022-09-28 增加串口指令
2022-09-29 增加指令和基本逻辑
2022-10-02 已完成全部功能
2022-10-09 修改hx711读数计算方法，目前为电压值x1000mV
2022-10-10 修改hx711计算方法
2022-10-12 修改hx711计算方式，输出重量
2022-10-13 更新协议文档
2022-10-25 1、修改批量基础设置长度错误问题
    2、增加手动开锁上报
    3、修改上位机控制led闪烁问题
2022-10-25 增加看门狗功能
2022-10-25 修改设置闪烁回复不一致问题
2022-10-26 修改上报重量AD为4个字节
2022-11-15 增加数码管应答超时功能
2022-11-17 增加设置和读取校准参数接口
2023-01-28 1、增加基于地址批量开关锁指令 2、增加基于地址批量设置闪烁指令 3、增加基于地址批量清除警报指令 4、增加基于地址批量清除数码管显示指令
2023-02-02 1、增加基于地址批量设置数码管显示内容指令 2、增加批量设置数码管显示内容指令
2023-08-01 版本：bulletLock_S01_20230801 修改内容： 1、修改波特率为4800 2、增加串口接收溢出错误处理
2023-09-10 版本：bulletLock_S02_20230910 修改内容： 1、增加修改波特率功能
